adriangrosu17/MT_Sincretic/Pictures/IMG_20180106_222700.jpg

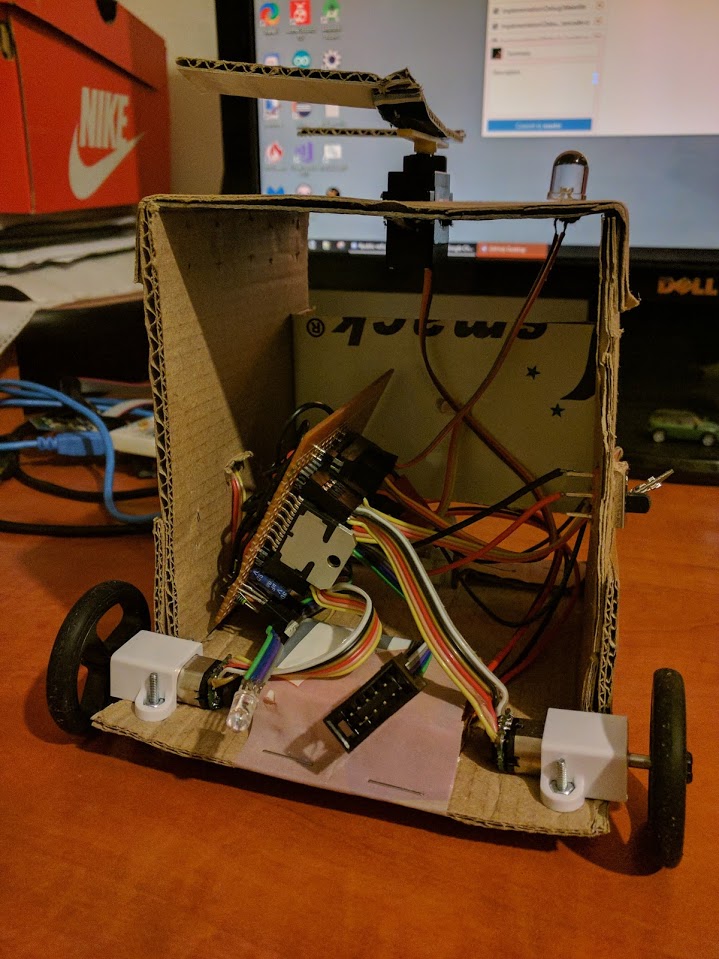
Pictures/IMG_20180106_222700.jpg
