adriangrosu17/MT_Sincretic/Pictures/IMG_20180106_222652.jpg

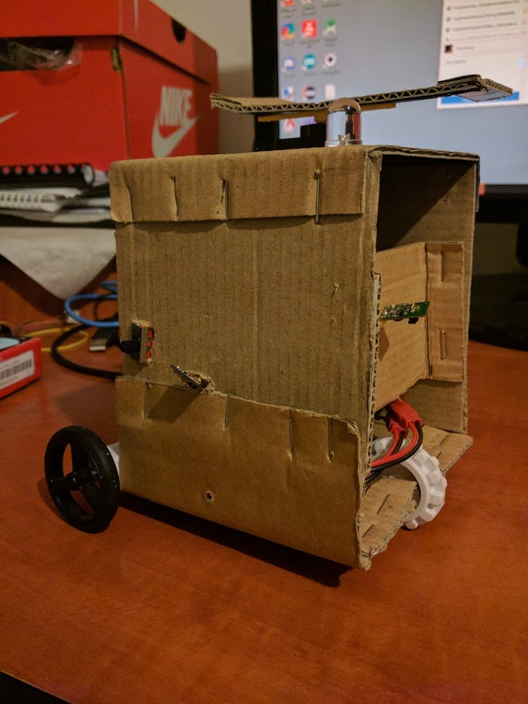
Pictures/IMG_20180106_222652.jpg
