adriangrosu17/MT_Sincretic/Pictures/IMG_20171217_005041.jpg

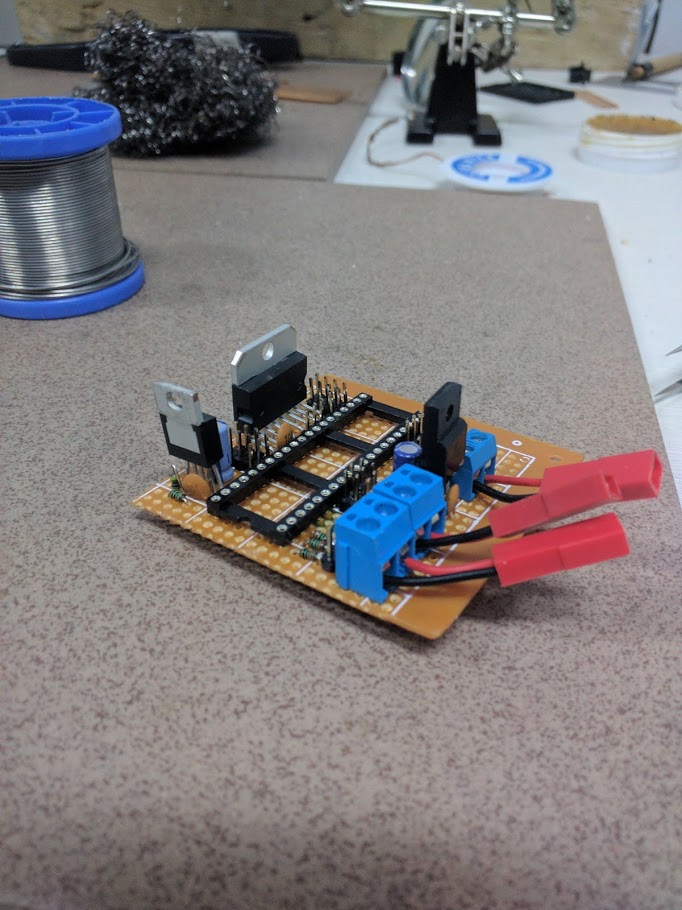
Pictures/IMG_20171217_005041.jpg
