adriangrosu17/MT_Sincretic/Pictures/IMG_20171218_021545.jpg

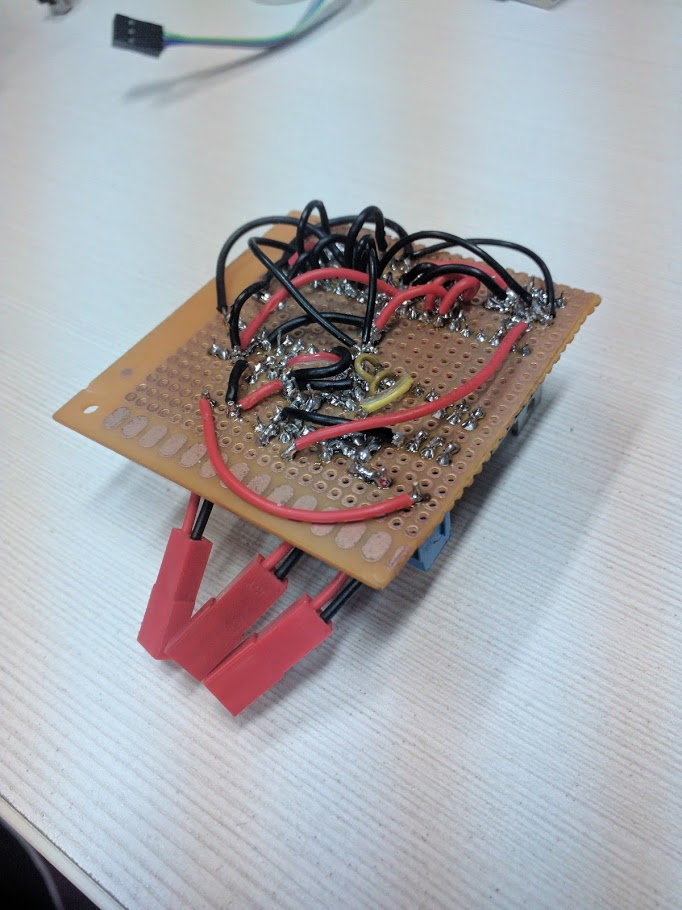
Pictures/IMG_20171218_021545.jpg
