adriangrosu17/MT_Sincretic/Pictures/IMG_20171218_030041.jpg

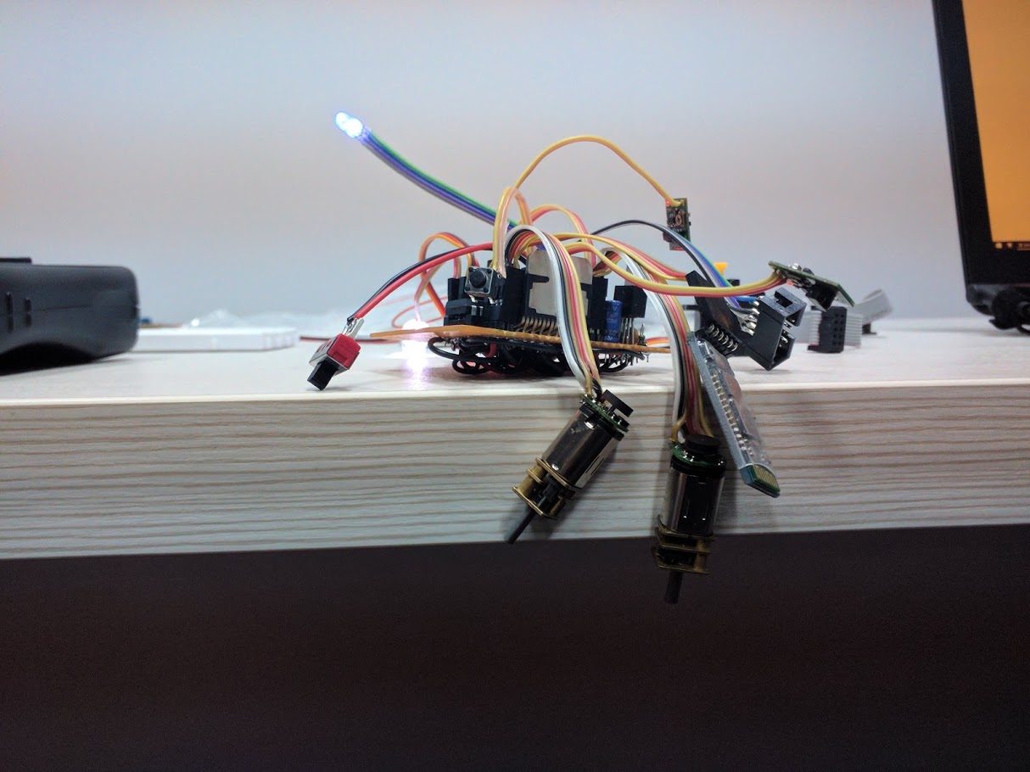
Pictures/IMG_20171218_030041.jpg
