adriangrosu17/MT_Sincretic/Rev 1_old/Line Follower.brd

## EAGLE design Rev 1_old/Line Follower.brd (2018-03-05, an earlier design)

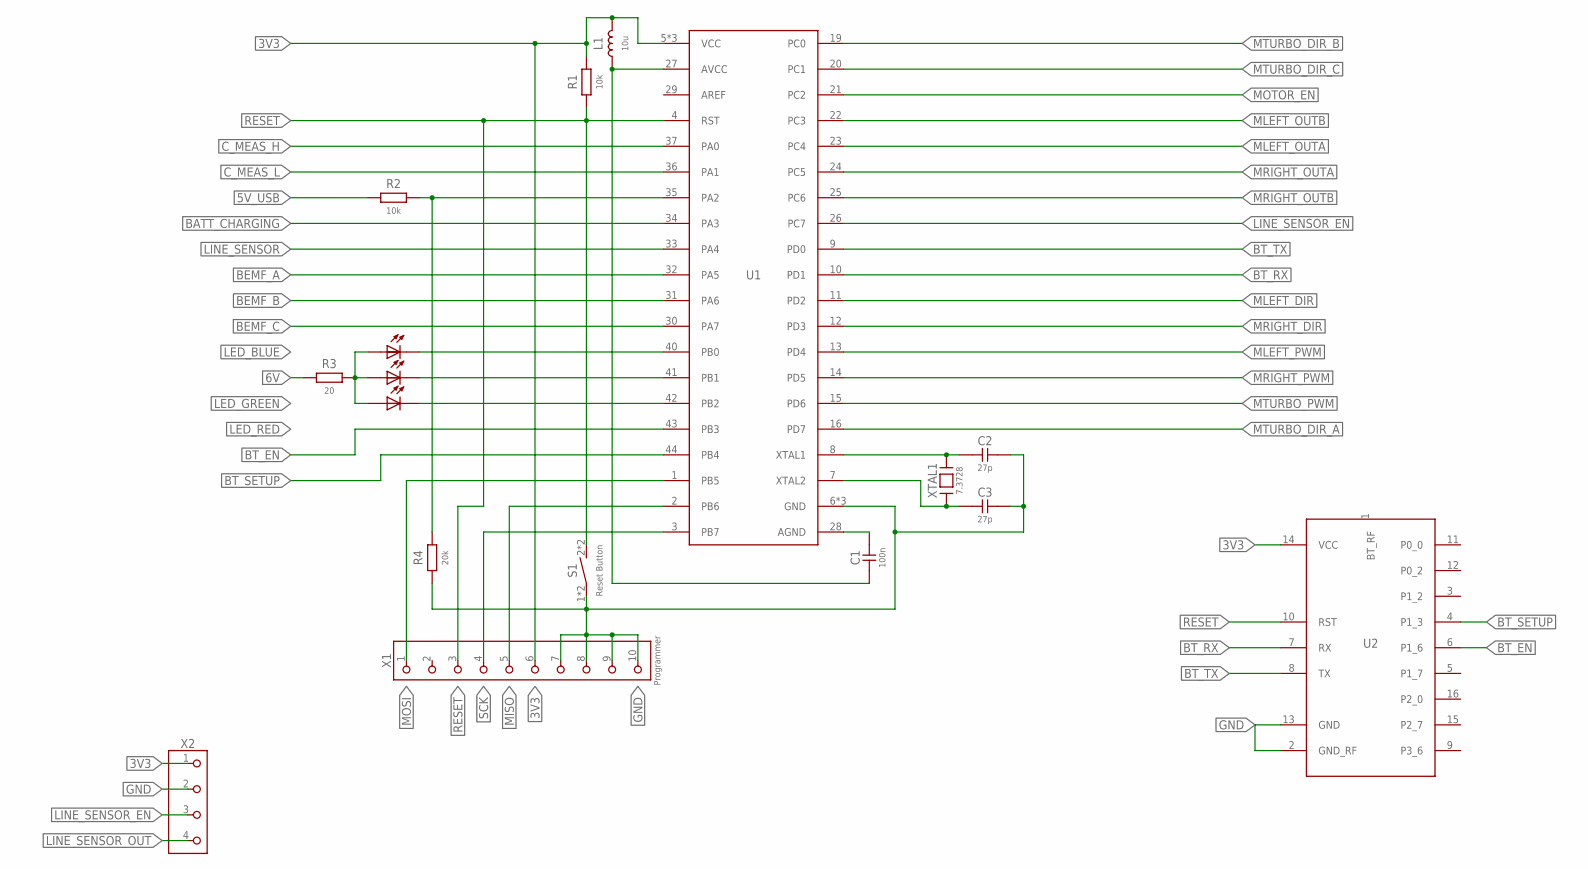
[picture p6: schematic Line Follower.sch, sheet 1, Logic]

Parts:
C1: 100n; SMD_1206
C2, C3: 27p; SMD_1206
D1: RGB_LEDOSTCXBSEC1E; OSTCXBSEC1E
L1: 10u; SMD_1206
R1, R2: 10k; SMD_1206
R3: 20; SMD_1206
R4: 20k; SMD_1206
S1: Reset Button; SCHURTER_BUTTON
U1: ATMEGA1284TQFP; TQFP-44
U2: RN4871
X1: Programmer; MALE_1WAY_2X5
X2: CONNECTOR_4PINMALE_PIN_1X4; MALE_PIN_1X4
XTAL1: 7.3728; SMD_OSCILLATOR

Connections:
3V3: L1.2, R1.2, U1.5 (VCC), U1.17 (VCC), U1.38 (VCC), U2.14 (VCC), X1.6, X2.1; also elsewhere on the board
5V_USB: R2.1; also elsewhere on the board
6V: R3.2; also elsewhere on the board
AVCC: C1.1, L1.1, U1.27 (AVCC)
BATT_CHARGING: U1.34 (PA3); also elsewhere on the board
BEMF_A: U1.32 (PA5); also elsewhere on the board
BEMF_B: U1.31 (PA6); also elsewhere on the board
BEMF_C: U1.30 (PA7); also elsewhere on the board
BT_EN: U1.43 (PB3), U2.6 (P1_6)
BT_RX: U1.10 (PD1), U2.7 (RX)
BT_SETUP: U1.44 (PB4), U2.4 (P1_3)
BT_TX: U1.9 (PD0), U2.8 (TX)
C_MEAS_H: U1.37 (PA0); also elsewhere on the board
C_MEAS_L: U1.36 (PA1); also elsewhere on the board
GND: C2.1, C3.1, R4.1, S1.1, S1.3, U1.6 (GND), U1.18 (GND), U1.39 (GND), U2.2 (GND_RF), U2.13 (GND), X1.7, X1.8, X1.9, X1.10, X2.2; also elsewhere on the board
LED_BLUE: D1.3 (K), U1.40 (PB0)
LED_GREEN: D1.1 (K), U1.41 (PB1)
LED_RED: D1.2 (K), U1.42 (PB2)
LINE_SENSOR: U1.33 (PA4)
LINE_SENSOR_EN: U1.26 (PC7), X2.3; also elsewhere on the board
LINE_SENSOR_OUT: X2.4; also elsewhere on the board
MISO: U1.2 (PB6), X1.5
MLEFT_DIR: U1.11 (PD2); also elsewhere on the board
MLEFT_OUTA: U1.23 (PC4); also elsewhere on the board
MLEFT_OUTB: U1.22 (PC3); also elsewhere on the board
MLEFT_PWM: U1.13 (PD4); also elsewhere on the board
MOSI: U1.1 (PB5), X1.1
MOTOR_EN: U1.21 (PC2); also elsewhere on the board
MRIGHT_DIR: U1.12 (PD3); also elsewhere on the board
MRIGHT_OUTA: U1.24 (PC5); also elsewhere on the board
MRIGHT_OUTB: U1.25 (PC6); also elsewhere on the board
MRIGHT_PWM: U1.14 (PD5); also elsewhere on the board
MTURBO_DIR_A: U1.16 (PD7); also elsewhere on the board
MTURBO_DIR_B: U1.19 (PC0); also elsewhere on the board
MTURBO_DIR_C: U1.20 (PC1); also elsewhere on the board
MTURBO_PWM: U1.15 (PD6); also elsewhere on the board
unnamed: C3.2, U1.7 (XTAL2), XTAL1.1
unnamed: C2.2, U1.8 (XTAL1), XTAL1.2
unnamed: C1.2, U1.28 (AGND)
unnamed: D1.4 (A), D1.5 (A), D1.6 (A), D1.PAD (A), R3.1
RESET: R1.1, S1.2 (S), S1.4 (S), U1.4 (RST), U2.10 (RST), X1.3
SCK: U1.3 (PB7), X1.4
USB_CONNECTED: R2.2, R4.2, U1.35 (PA2)

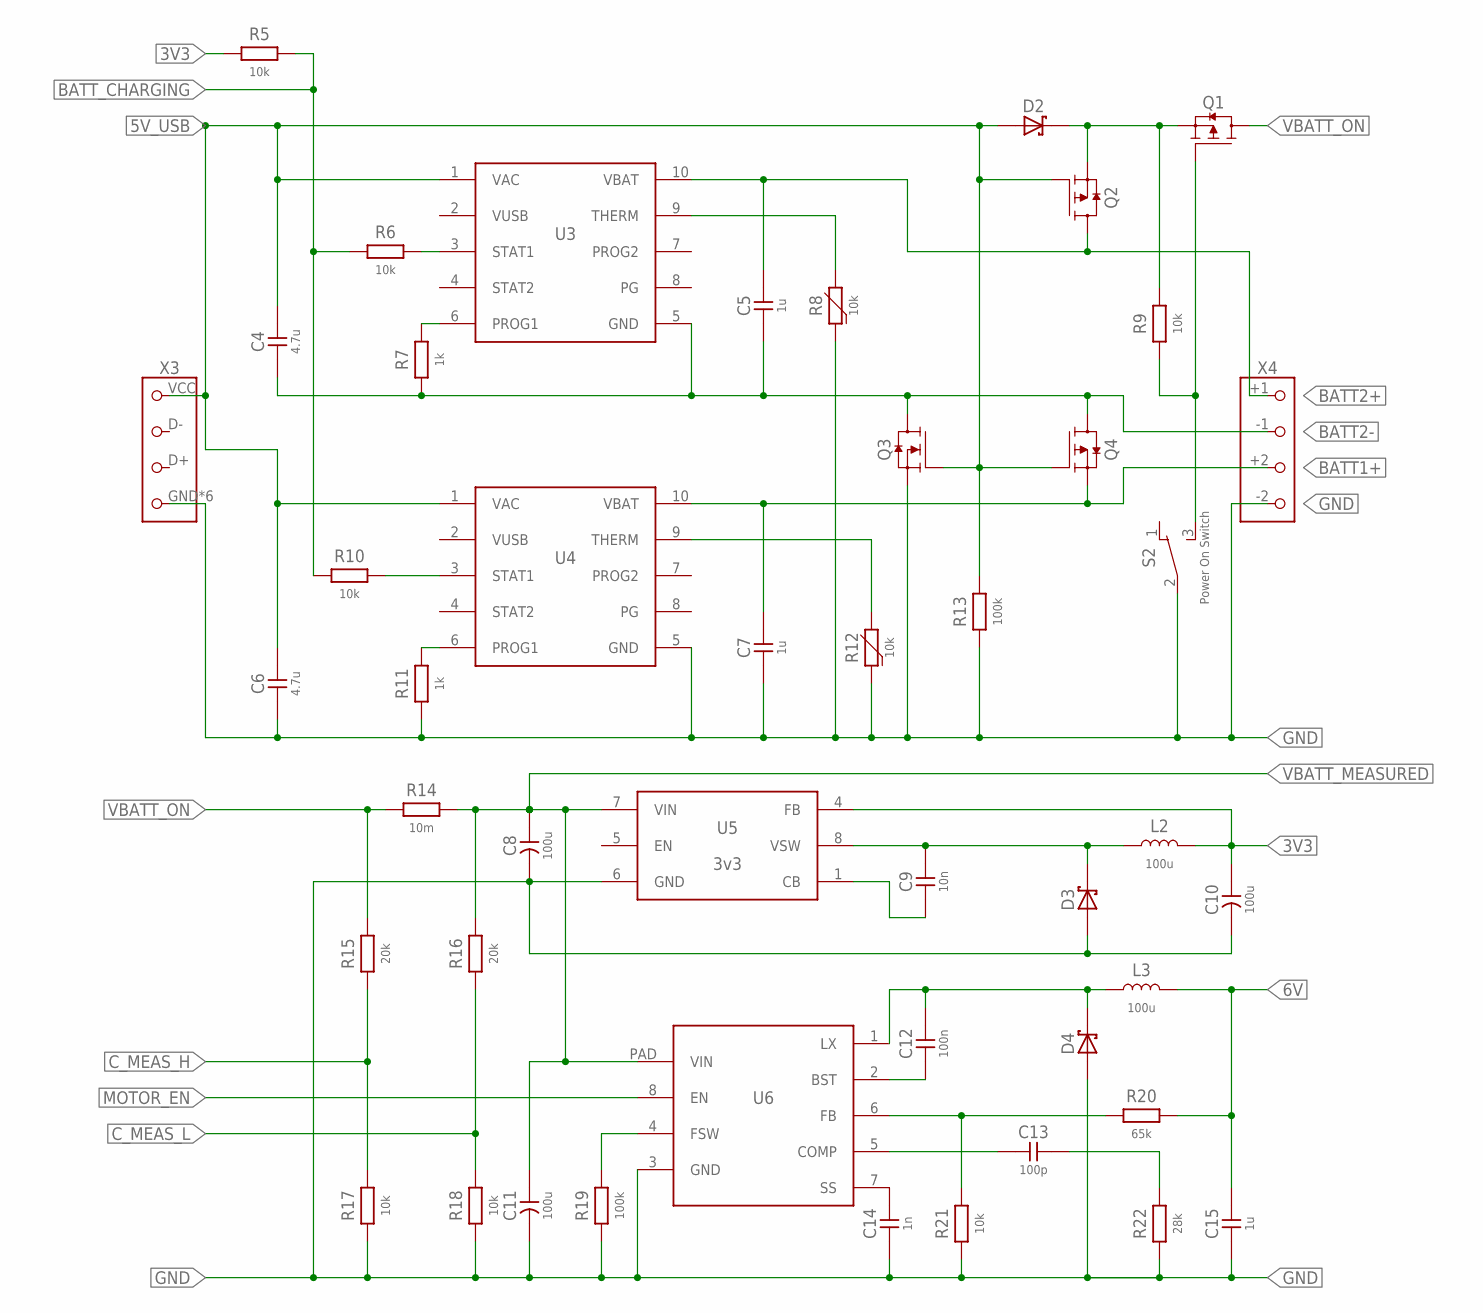
[picture p7: schematic Line Follower.sch, sheet 2, Power supply]

Parts:
C4, C6: 4.7u; SMD_1206
C5, C7, C15: 1u; SMD_1206
C8, C10, C11: 100u; SMD_1210
C9: 10n; SMD_1206
C12: 100n; SMD_1206
C13: 100p; SMD_1206
C14: 1n; SMD_1206
D2, D3, D4: BAS3010BSOD232; SOD323
L2, L3: 100u; SMD_1206
Q1, Q2, Q4: AOD417; TO-252
Q3: AOD480; TO-252
R5, R6, R9, R10, R17, R18, R21: 10k; SMD_1206
R7, R11: 1k; SMD_1206
R8, R12: 10k; SMD_0805
R13, R19: 100k; SMD_1206
R14: 10m; SMD_1206
R15, R16: 20k; SMD_1206
R20: 65k; SMD_1206
R22: 28k; SMD_1206
S2: Power On Switch; NINIGI_5MS1
U3, U4: MCP73837MSOP_10; MSOP_10
U5: 3v3; SO8
U6: AOZ1284; SO8_EP
X3: USB_CONNECTORMICRO_USB; MICRO_USB_FEMALE
X4: CONNECTOR_4PINBATTERY_18650X2; BATTERY_186501X2

Connections:
3V3: C10.1 (+), L2.2, R5.1, U5.4 (FB); also elsewhere on the board
5V_USB: C4.2, C6.2, D2.1 (A), Q2.1 (G), Q3.1 (G), Q4.1 (G), R13.2, U3.1 (VAC), U4.1 (VAC), X3.VCC (1); also elsewhere on the board
6V: C15.2, L3.2, R20.2; also elsewhere on the board
BATT1+: C7.2, Q4.2 (S), U4.10 (VBAT), X4.+2 (3)
BATT2+: C5.2, Q2.3 (D), U3.10 (VBAT), X4.+1 (1)
BATT2-: C4.1, C5.1, Q3.3 (D), Q4.3 (D), R7.1, U3.5 (GND), X4.-1 (2)
BATTERY1_CHARGING1: R10.2, U4.3 (STAT1)
BATTERY2_CHARGING1: R6.2, U3.3 (STAT1)
BATT_CHARGING: R5.2, R6.1, R10.1; also elsewhere on the board
C_MEAS_H: R15.1, R17.2; also elsewhere on the board
C_MEAS_L: R16.1, R18.2; also elsewhere on the board
GND: C6.1, C7.1, C8.2 (-), C10.2 (-), C11.2 (-), C14.1, C15.1, D3.1 (A), D4.1 (A), Q3.2 (S), R8.1, R11.1, R12.1, R13.1, R17.1, R18.1, R19.1, R21.1, R22.1, S2.2 (MIDDLE), U4.5 (GND), U5.6 (GND), U6.3 (GND), X3.GND (4), X3.NC (4), X3.NC@2 (4), X3.NC@3 (4), X3.NC@4 (4), X3.NC@5 (4), X4.-2 (4); also elsewhere on the board
MOTOR_EN: U6.8 (EN); also elsewhere on the board
unnamed: C9.1, U5.1 (CB)
unnamed: R19.2, U6.4 (FSW)
unnamed: C14.2, U6.7 (SS)
unnamed: C13.1, U6.5 (COMP)
unnamed: C13.2, R22.2
unnamed: C12.1, U6.2 (BST)
unnamed: C12.2, D4.2 (K), L3.1, U6.1 (LX)
unnamed: R20.1, R21.2, U6.6 (FB)
THERM2: R12.2, U4.9 (THERM)
THERM3: R8.2, U3.9 (THERM)
VBATT1: D2.2 (K), Q1.2 (S), Q2.2 (S), R9.2
VBATT_MEASURED: C8.1 (+), C11.1 (+), R14.2, R16.2, U5.7 (VIN), U6.PAD (VIN); also elsewhere on the board
VBATT_ON: Q1.3 (D), R14.1, R15.2
VG1: Q1.1 (G), R9.1, S2.3 (SIDE2)
VSW: C9.2, D3.2 (K), L2.1, U5.8 (VSW)
VUSB: U3.2 (VUSB), U4.2 (VUSB)
V_LIMIT2: R11.2, U4.6 (PROG1)
V_LIMIT3: R7.2, U3.6 (PROG1)

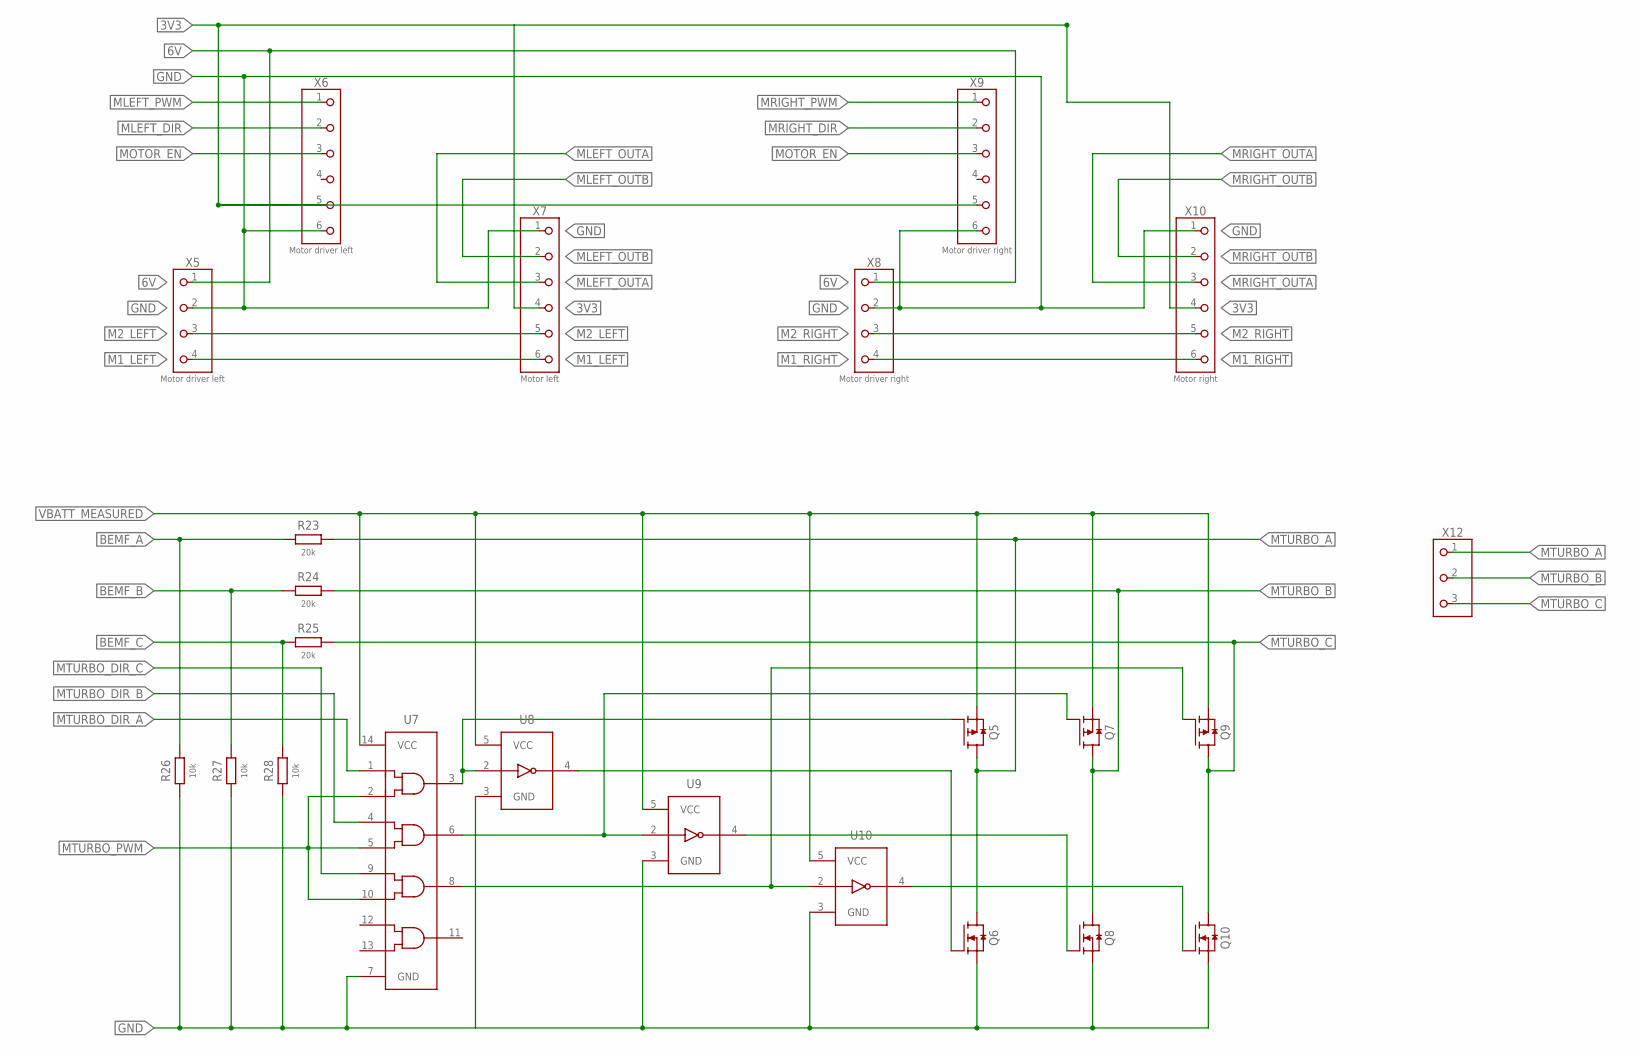
[picture p8: schematic Line Follower.sch, sheet 3, Motors]

Parts:
Q5, Q7, Q9: AOD417; TO-252
Q6, Q8, Q10: AOD480; TO-252
R23, R24, R25: 20k; SMD_1206
R26, R27, R28: 10k; SMD_1206
U7: 74AHC08D; SO14
U8, U9, U10: 74LVC1G14SOT25; SOT25
X5: Motor driver left; MALE_PIN_1X4
X6: Motor driver left; MALE_PIN_1X6
X7: Motor left; MALE_PIN_2X3
X8: Motor driver right; MALE_PIN_1X4
X9: Motor driver right; MALE_PIN_1X6
X10: Motor right; MALE_PIN_2X3
X12: CONNECTOR_3PIN; SCREW_1X3

Connections:
3V3: X6.5, X7.4, X9.5, X10.4; also elsewhere on the board
6V: X5.1, X8.1; also elsewhere on the board
BEMF_A: R23.1, R26.2; also elsewhere on the board
BEMF_B: R24.1, R27.2; also elsewhere on the board
BEMF_C: R25.1, R28.2; also elsewhere on the board
GND: Q6.2 (S), Q8.2 (S), Q10.2 (S), R26.1, R27.1, R28.1, U7.7 (GND), U8.3 (GND), U9.3 (GND), U10.3 (GND), X5.2, X6.6, X7.1, X8.2, X9.6, X10.1; also elsewhere on the board
M1_LEFT: X5.4, X7.6
M1_RIGHT: X8.4, X10.6
M2_LEFT: X5.3, X7.5
M2_RIGHT: X8.3, X10.5
MLEFT_DIR: X6.2; also elsewhere on the board
MLEFT_OUTA: X7.3; also elsewhere on the board
MLEFT_OUTB: X7.2; also elsewhere on the board
MLEFT_PWM: X6.1; also elsewhere on the board
MOTOR_EN: X6.3, X9.3; also elsewhere on the board
MRIGHT_DIR: X9.2; also elsewhere on the board
MRIGHT_OUTA: X10.3; also elsewhere on the board
MRIGHT_OUTB: X10.2; also elsewhere on the board
MRIGHT_PWM: X9.1; also elsewhere on the board
MTURBO_A: Q5.3 (D), Q6.3 (D), R23.2, X12.1
MTURBO_B: Q7.3 (D), Q8.3 (D), R24.2, X12.2
MTURBO_C: Q9.3 (D), Q10.3 (D), R25.2, X12.3
MTURBO_DIR_A: U7.1 (A1); also elsewhere on the board
MTURBO_DIR_B: U7.4 (A2); also elsewhere on the board
MTURBO_DIR_C: U7.9 (A3); also elsewhere on the board
MTURBO_PWM: U7.2 (B1), U7.5 (B2), U7.10 (B3); also elsewhere on the board
unnamed: Q5.1 (G), U7.3 (Y1), U8.2 (A)
unnamed: Q6.1 (G), U8.4 (Y)
unnamed: Q7.1 (G), U7.6 (Y2), U9.2 (A)
unnamed: Q8.1 (G), U9.4 (Y)
unnamed: Q10.1 (G), U10.4 (Y)
unnamed: Q9.1 (G), U7.8 (Y3), U10.2 (A)
VBATT_MEASURED: Q5.2 (S), Q7.2 (S), Q9.2 (S), U7.14 (VCC), U8.5 (VCC), U9.5 (VCC), U10.5 (VCC); also elsewhere on the board

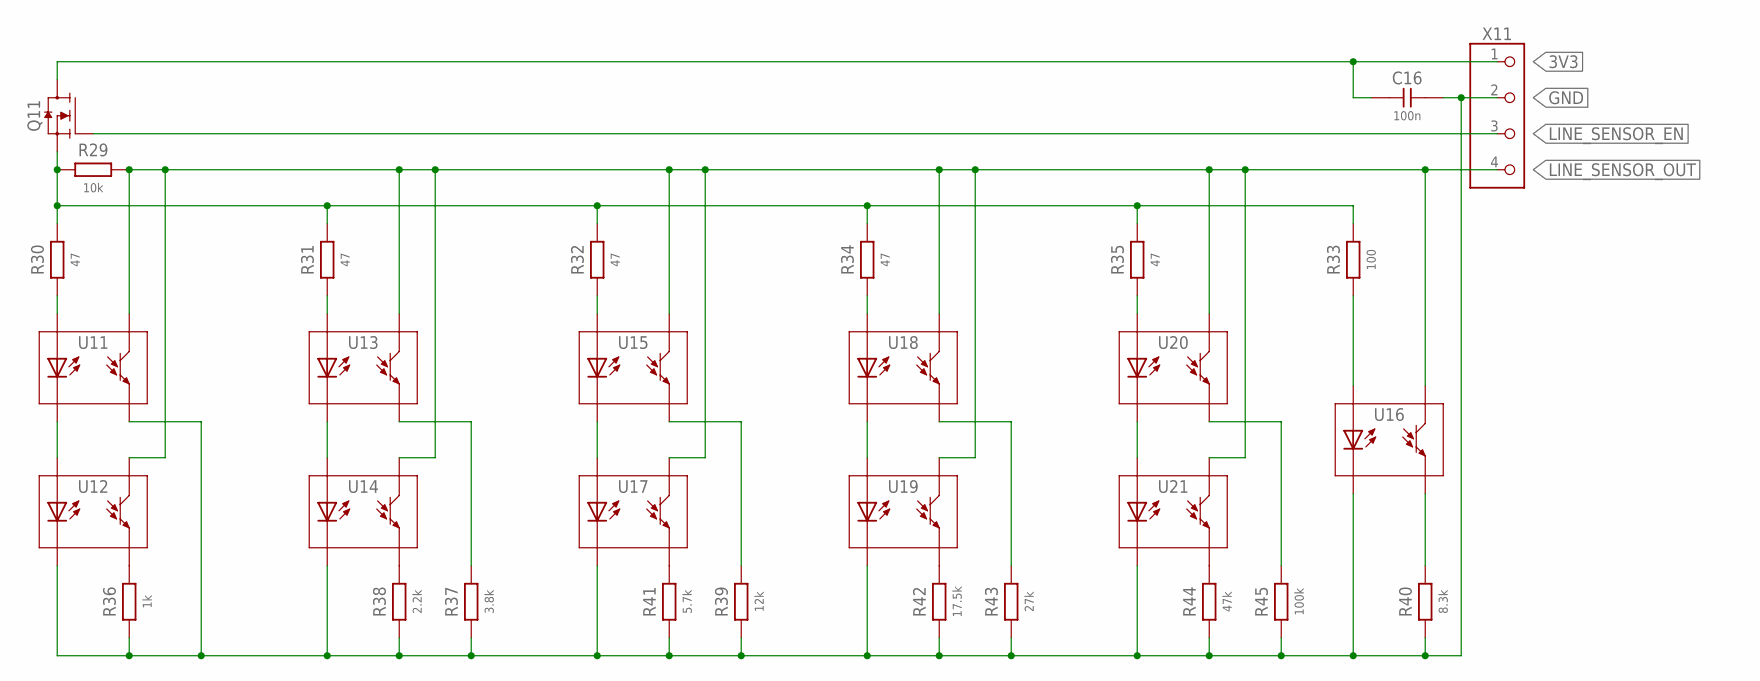
[picture p9: schematic Line Follower.sch, sheet 4, Sensors]

Parts:
C16: 100n; SMD_1206
Q11: AO3414SOT23; SOT23
R29: 10k; SMD_1206
R30, R31, R32, R34, R35: 47; SMD_1206
R33: 100; SMD_1206
R36: 1k; SMD_1206
R37: 3.8k; SMD_1206
R38: 2.2k; SMD_1206
R39: 12k; SMD_1206
R40: 8.3k; SMD_1206
R41: 5.7k; SMD_1206
R42: 17.5k; SMD_1206
R43: 27k; SMD_1206
R44: 47k; SMD_1206
R45: 100k; SMD_1206
U11, U12, U13, U14, U15, U16, U17, U18, U19, U20, U21: EE-SY171
X11: CONNECTOR_4PINMALE_PIN_1X4; MALE_PIN_1X4

Connections:
3V3: C16.1, Q11.3 (D), X11.1; also elsewhere on the board
3V3_SENSOR_LEDS: Q11.2 (S), R29.1, R30.2, R31.2, R32.2, R33.2, R34.2, R35.2
GND: C16.2, R36.1, R37.1, R38.1, R39.1, R40.1, R41.1, R42.1, R43.1, R44.1, R45.1, U11.E, U12.K, U14.K, U16.K, U17.K, U19.K, U21.K, X11.2; also elsewhere on the board
LINE_SENSOR_EN: Q11.1 (G), X11.3; also elsewhere on the board
LINE_SENSOR_OUT: R29.2, U11.C, U12.C, U13.C, U14.C, U15.C, U16.C, U17.C, U18.C, U19.C, U20.C, U21.C, X11.4; also elsewhere on the board
unnamed: R36.2, U12.E
unnamed: R37.2, U13.E
unnamed: R30.1, U11.A
unnamed: U11.K, U12.A
unnamed: R32.1, U15.A
unnamed: R31.1, U13.A
unnamed: U13.K, U14.A
unnamed: U15.K, U17.A
unnamed: R34.1, U18.A
unnamed: U18.K, U19.A
unnamed: R35.1, U20.A
unnamed: U20.K, U21.A
unnamed: R33.1, U16.A
unnamed: R38.2, U14.E
unnamed: R41.2, U17.E
unnamed: R39.2, U15.E
unnamed: R43.2, U18.E
unnamed: R42.2, U19.E
unnamed: R45.2, U20.E
unnamed: R44.2, U21.E
unnamed: R40.2, U16.E

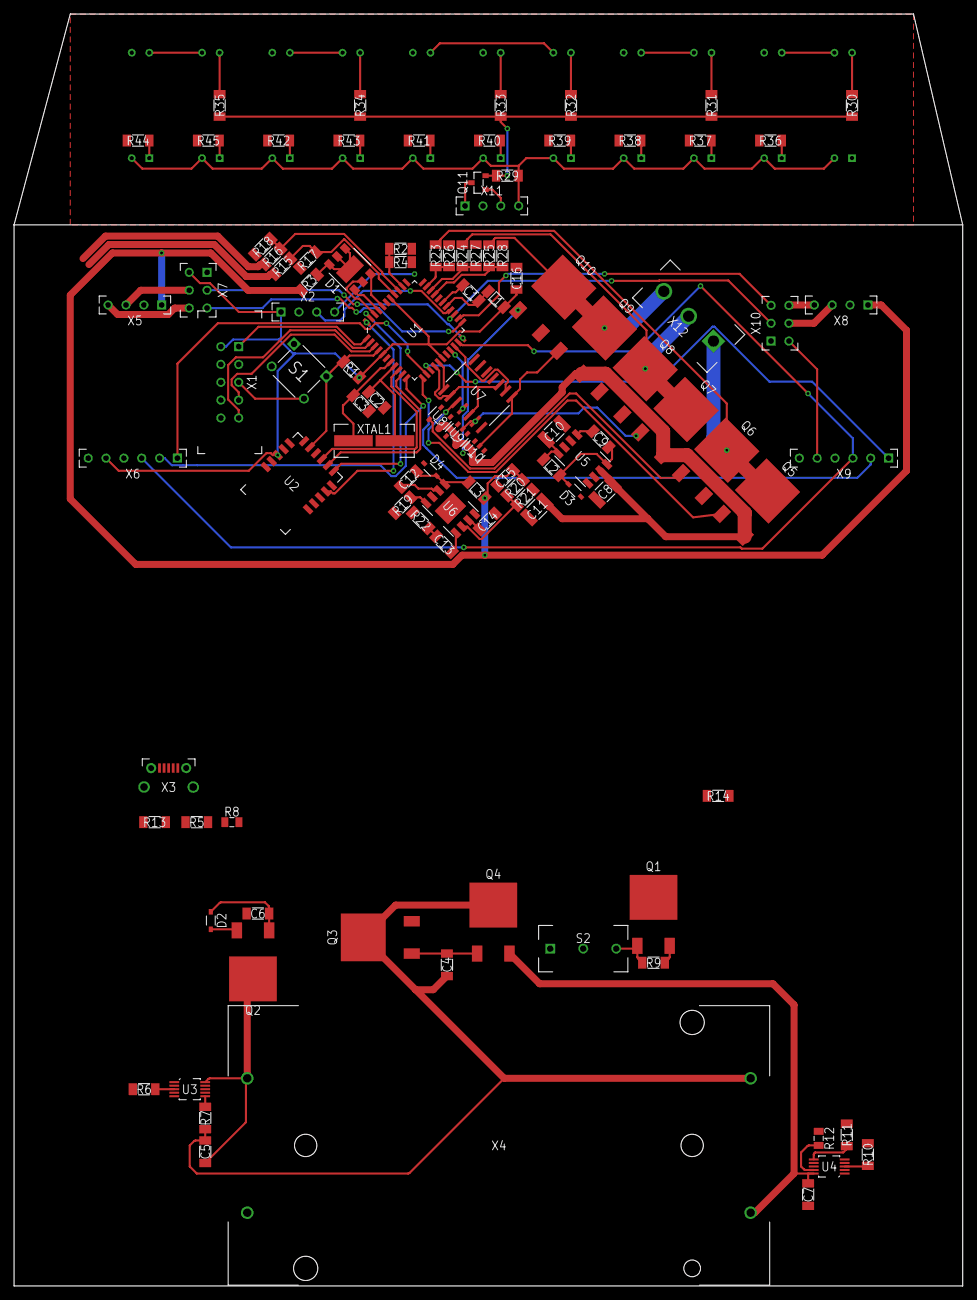
[picture p10: board Line Follower.brd from above]

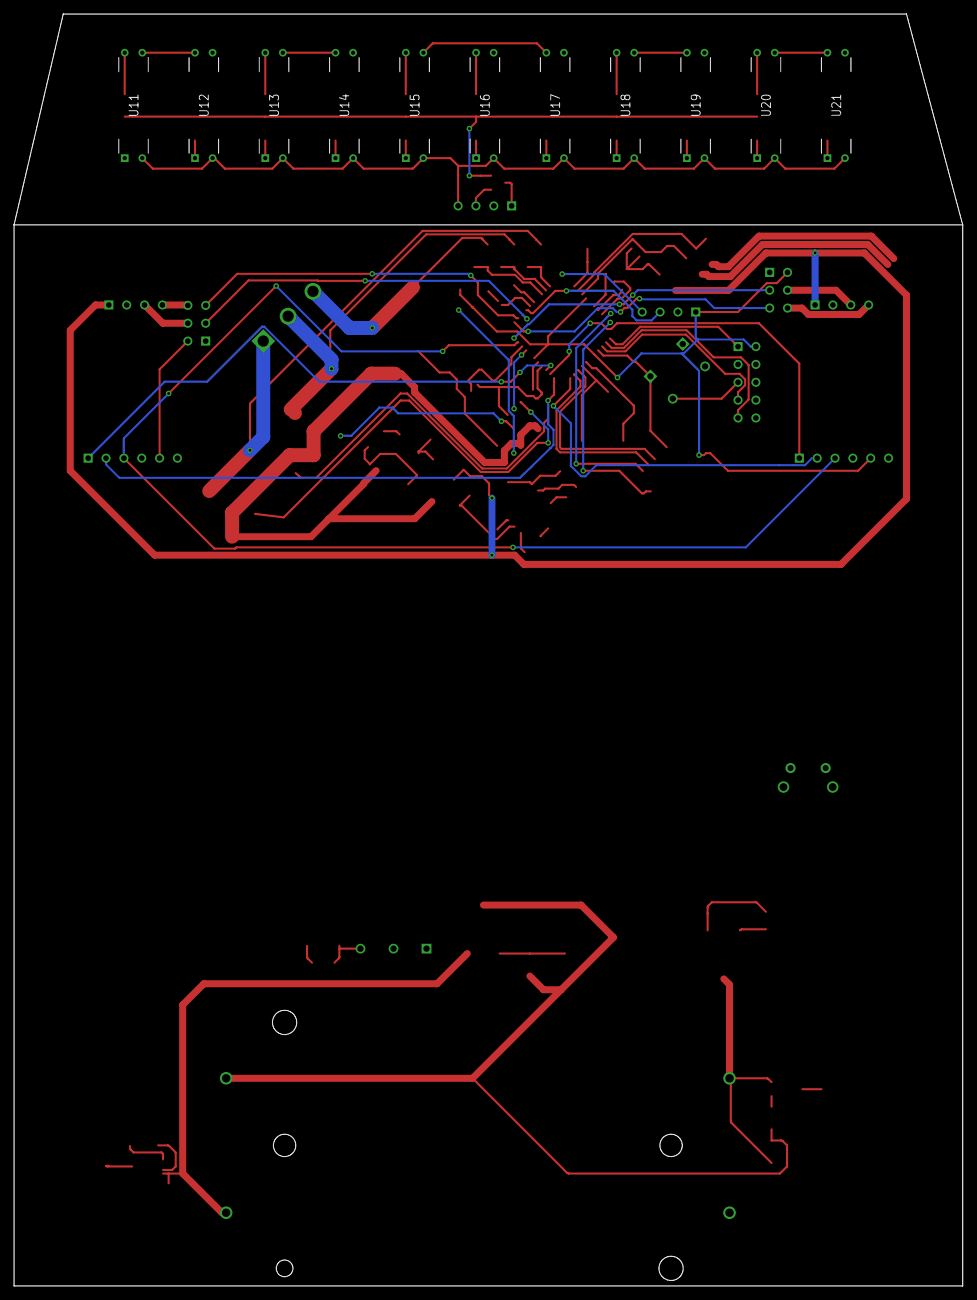
[picture p11: board Line Follower.brd from below]

Board: 2 copper layers, 135.0 x 181.0 mm, 115 parts (11 on the bottom side), 100 nets.
