adriangrosu17/MT_Sincretic/Tank/Tank/untitled.brd

## EAGLE design Tank/Tank/untitled.brd (2018-01-01)

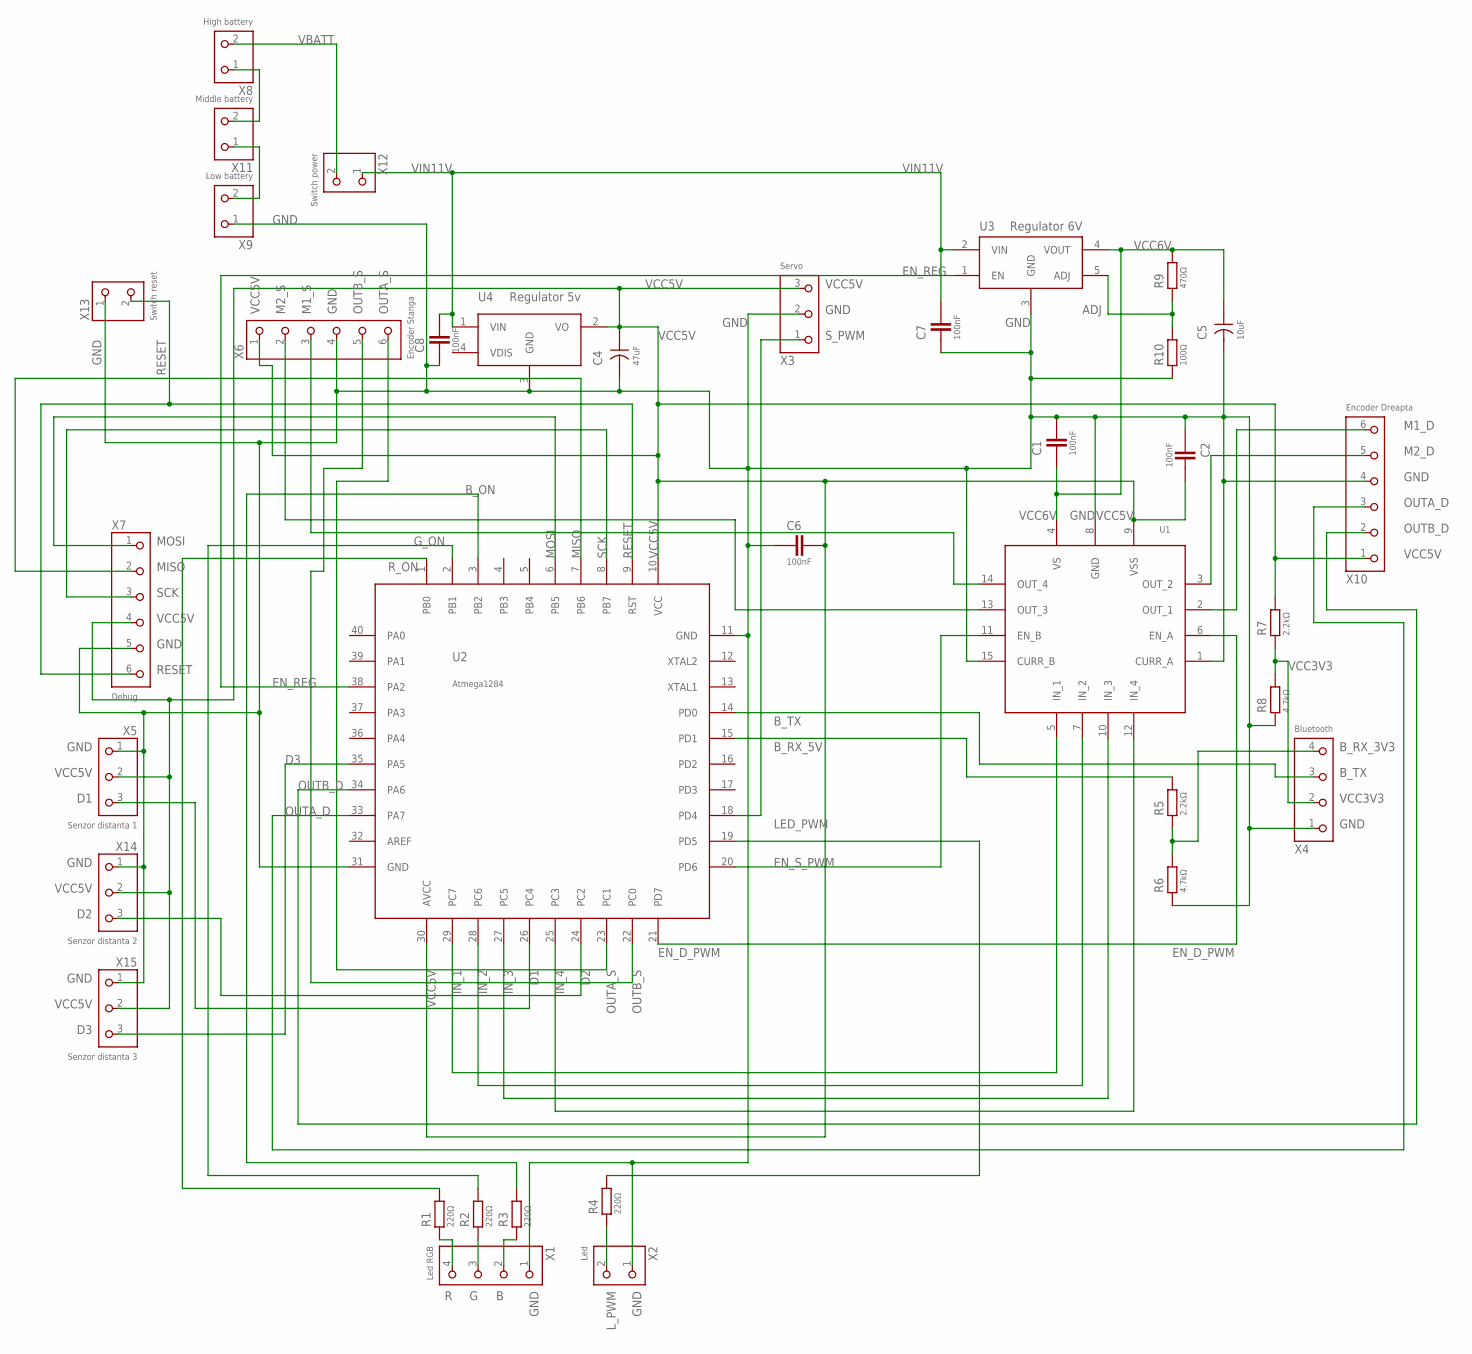
[picture p12: schematic untitled.sch]

Parts:
C1, C2, C6, C7, C8: 100nF; THT_2.54
C4: 47uF; ELECTROLYTIC_5MM_PEFRBOARD
C5: 10uF; ELECTROLYTIC_5MM_PEFRBOARD
R1, R2, R3, R4: 220Ω; THT_5.08
R5: 2.2kΩ; THT_2.54
R6, R8: 4.7kΩ; THT_5.08
R7: 2.2kΩ; THT_5.08
R9: 470Ω; THT_2.54
R10: 100Ω; THT_5.08
U1: L298NMULTIWATT15V_PERFBOARD; MULTIWATT15V_PERFBOARD
U2: Atmega1284; DIP-40
U3: Regulator 6V; TO-220-5_PERFBOARD
U4: Regulator 5v; TO-220-4
X1: Led RGB; MALE_PIN_1X4
X2: Led; MALE_PIN_1X2
X3: Servo; MALE_PIN_1X3
X4: Bluetooth; MALE_PIN_1X4
X5: Senzor distanta 1; MALE_PIN_1X3
X6: Encoder Stanga; MALE_PIN_2X3
X7: Debug; MALE_PIN_2X3
X8: High battery; FEMALE_SCREW_1X2
X9: Low battery; FEMALE_SCREW_1X2
X10: Encoder Dreapta; MALE_PIN_2X3
X11: Middle battery; FEMALE_SCREW_1X2
X12: Switch power; MALE_PIN_1X2
X13: Switch reset; MALE_PIN_1X2
X14: Senzor distanta 2; MALE_PIN_1X3
X15: Senzor distanta 3; MALE_PIN_1X3

Connections:
ADJ: R9.1, R10.2, U3.5 (ADJ)
B: R3.1, X1.2
B_ON: R3.2, U2.3 (PB2)
B_RX_3V3: R5.1, R6.2, X4.4
B_RX_5V: R5.2, U2.15 (PD1)
B_TX: U2.14 (PD0), X4.3
D1: U2.26 (PC4), X5.3
D2: U2.24 (PC2), X14.3
D3: U2.35 (PA5), X15.3
EN_D_PWM: U1.6 (EN_A), U2.21 (PD7)
EN_REG: U2.38 (PA2), U3.1 (EN)
EN_S_PWM: U1.11 (EN_B), U2.20 (PD6)
G: R2.1, X1.3
GND: C1.2, C2.1, C4.-, C5.-, C6.1, C7.1, C8.1, R6.1, R8.1, R10.1, U1.1 (CURR_A), U1.8 (GND), U1.15 (CURR_B), U2.11 (GND), U2.31 (GND), U3.3 (GND), U4.3 (GND), X1.1, X2.1, X3.2, X4.1, X5.1, X6.4, X7.5, X9.1, X10.4, X13.1, X14.1, X15.1
G_ON: R2.2, U2.2 (PB1)
IN_1: U1.5 (IN_1), U2.29 (PC7)
IN_2: U1.7 (IN_2), U2.28 (PC6)
IN_3: U1.10 (IN_3), U2.27 (PC5)
IN_4: U1.12 (IN_4), U2.25 (PC3)
LED_PWM: R4.2, U2.19 (PD5)
L_PWM: R4.1, X2.2
M1_D: U1.2 (OUT_1), X10.6
M1_S: U1.14 (OUT_4), X6.3
M2_D: U1.3 (OUT_2), X10.5
M2_S: U1.13 (OUT_3), X6.2
MISO: U2.7 (PB6), X7.2
MOSI: U2.6 (PB5), X7.1
unnamed: X8.1, X11.2
unnamed: X9.2, X11.1
OUTA_D: U2.33 (PA7), X10.3
OUTA_S: U2.23 (PC1), X6.6
OUTB_D: U2.34 (PA6), X10.2
OUTB_S: U2.22 (PC0), X6.5
R: R1.1, X1.4
RESET: U2.9 (RST), X7.6, X13.2
R_ON: R1.2, U2.1 (PB0)
SCK: U2.8 (PB7), X7.3
S_PWM: U2.18 (PD4), X3.1
VBATT: X8.2, X12.2
VCC3V3: R7.1, R8.2, X4.2
VCC5V: C2.2, C4.+, C6.2, R7.2, U1.9 (VSS), U2.10 (VCC), U2.30 (AVCC), U4.2 (VO), X3.3, X5.2, X6.1, X7.4, X10.1, X14.2, X15.2
VCC6V: C1.1, C5.+, R9.2, U1.4 (VS), U3.4 (VOUT)
VIN11V: C7.2, C8.2, U3.2 (VIN), U4.1 (VIN), X12.1

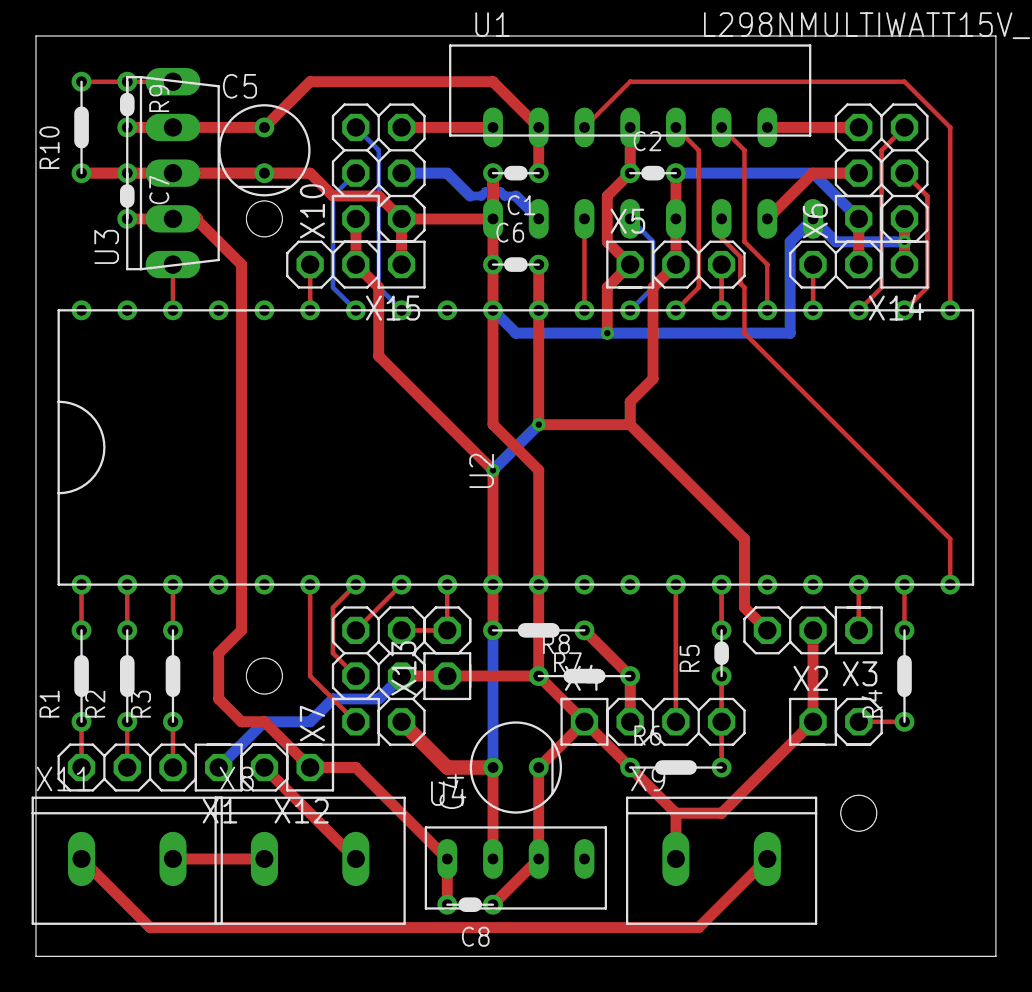
[picture p13: board untitled.brd from above]

Board: 2 copper layers, 53.3 x 51.1 mm, 36 parts (0 on the bottom side), 43 nets.
