adriangrosu17/MT_Sincretic/(commit log)

2017-10-25 ADC/PWM
    added adc.h/adc.c
    added pwm.h/pwm.c
2017-10-31 pwm/gpio
    fixed pwm bugs
    added gpio
    [gpio.c, gpio.h, main.c, pwm.c, uart.c, uart.h]
2017-11-07 UART
    Added UART implementation
2017-11-20 Electronic layout/schematic added
    Added the electronic schematic and board layout (built in Eagle)
    [untitled.brd, untitled.sch]
2018-01-01 laptop->pc test part
    [untitled.brd, untitled.sch]
2018-01-06 final push
    [communication_protocol.xlsx]
2018-03-05 robot 95% done
    [communication_protocol.xlsx]
2018-04-20 buffer for uart receive
